kpezeshki/16CH_PSU/multichannelheaterdriver_amc7836/amc7836/AMC7836IPAPR.step

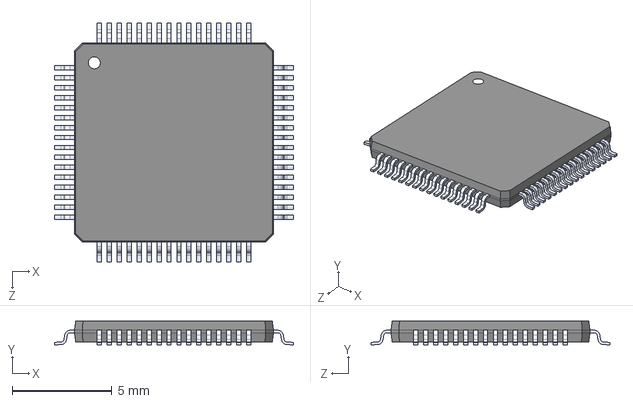
[picture p1: CAD file, 2025-02-01]
multichannelheaterdriver_amc7836/amc7836/AMC7836IPAPR.step
12.0 x 1.20 x 12.0 mm
