kpezeshki/16CH_PSU/multichannelheaterdriver_frontend/opamp_footprints/INA2180A4IDGKT.step

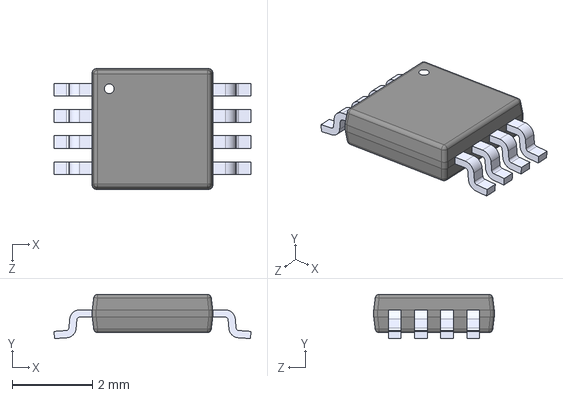
[picture p2: CAD file, 2025-02-01]
multichannelheaterdriver_frontend/opamp_footprints/INA2180A4IDGKT.step
4.90 x 1.10 x 3.00 mm
