kpezeshki/16CH_PSU/multichannelheaterdriver_frontend/opamp_footprints/ALM2403QPWPRQ1.step

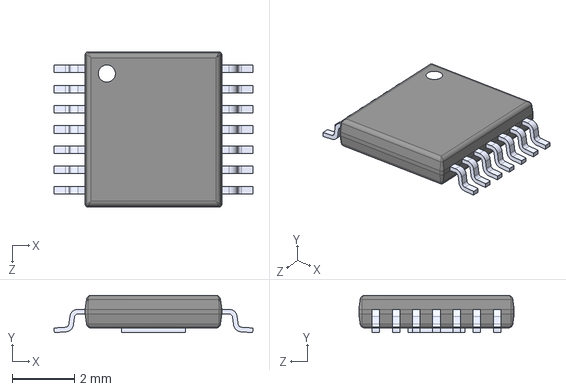
[picture p3: CAD file, 2025-02-01]
multichannelheaterdriver_frontend/opamp_footprints/ALM2403QPWPRQ1.step
6.40 x 1.20 x 5.00 mm
