kpezeshki/16CH_PSU/(threads)

Thread 1 (2025-02-01):

No firmware or software support for auxiliary ADCs on the AMC7836

kpezeshki, 2025-02-01:
Some of the AMC7836 single-ended ADCs are used internally for voltage rail monitoring, and some are broken out to headers on the data converter PCB. There is currently no firmware or GUI support for these. This should be added.

Thread 2 (2025-02-01):

High current tracks should all be >0.25 mm

kpezeshki, 2025-02-01:
The segment of track from the power op amp to shunt resistor is 0.25 mm. This should be increased to 0.5 mm to fix electromigration issues when the channel is operated at high current.
