kpezeshki/16CH_PSU/multichannelheaterdriver_amc7836/schematic.pdf

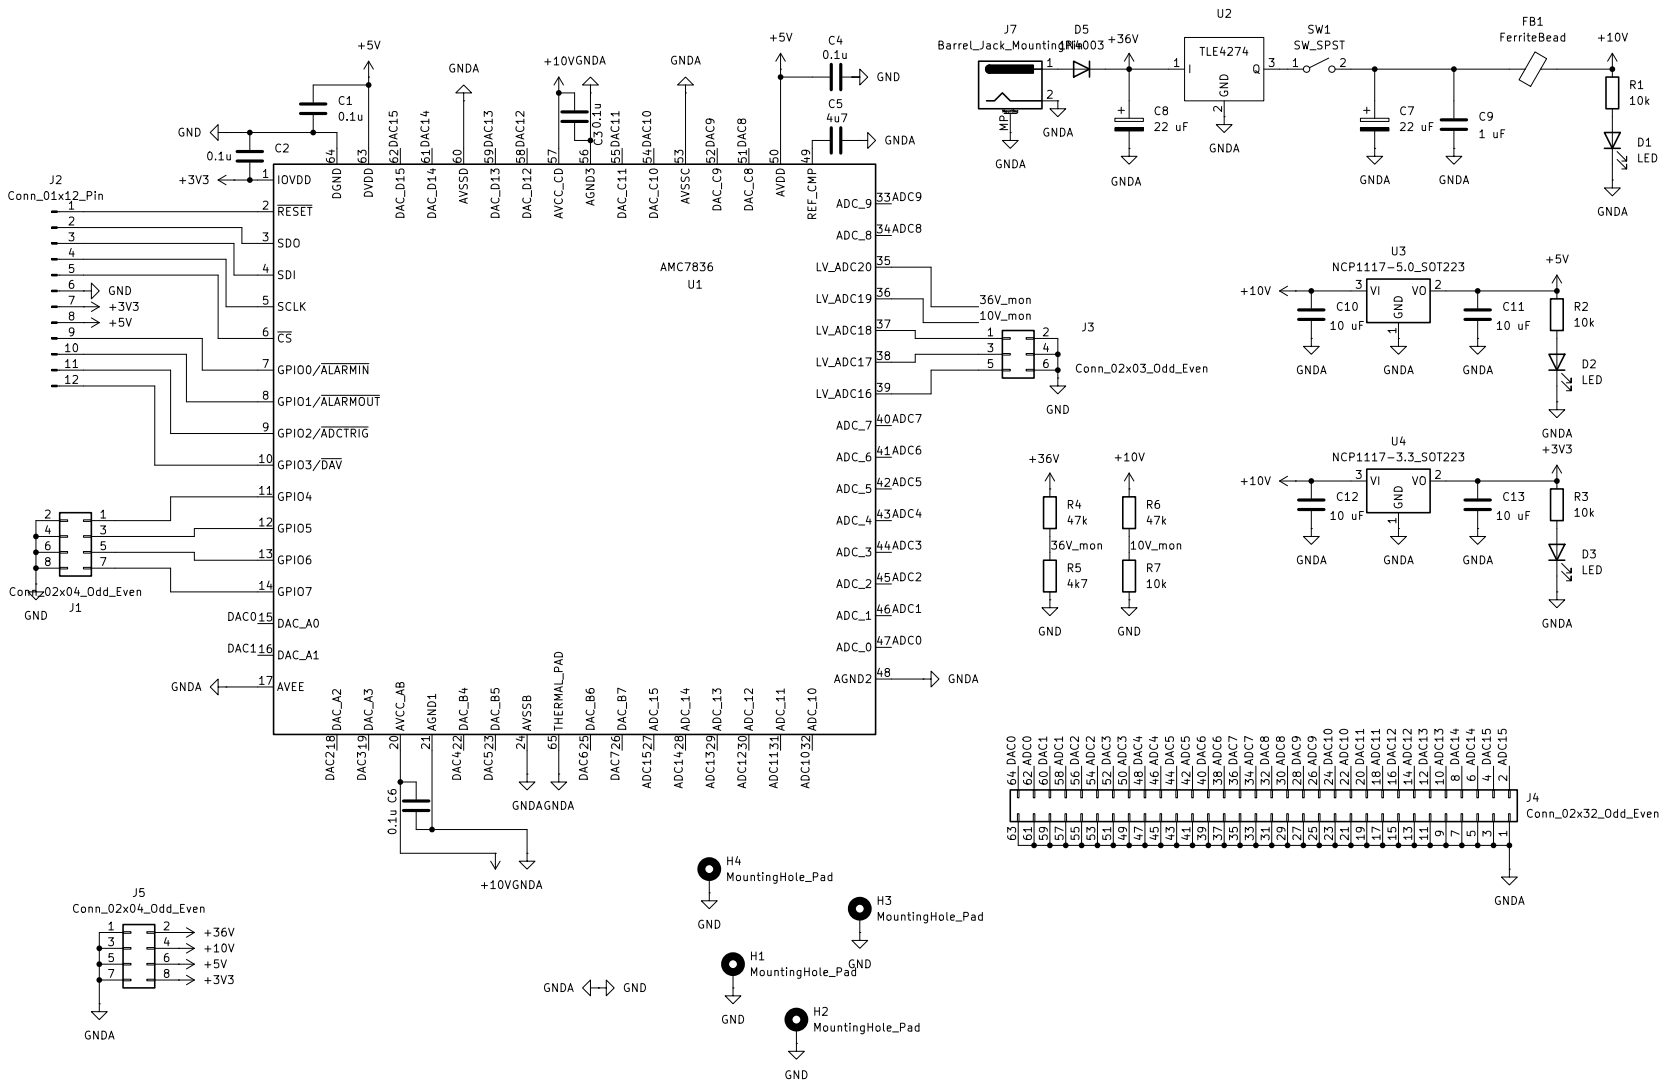
[picture p4: page 1]
