kpezeshki/16CH_PSU/multichannelheaterdriver_amc7836/layout.pdf

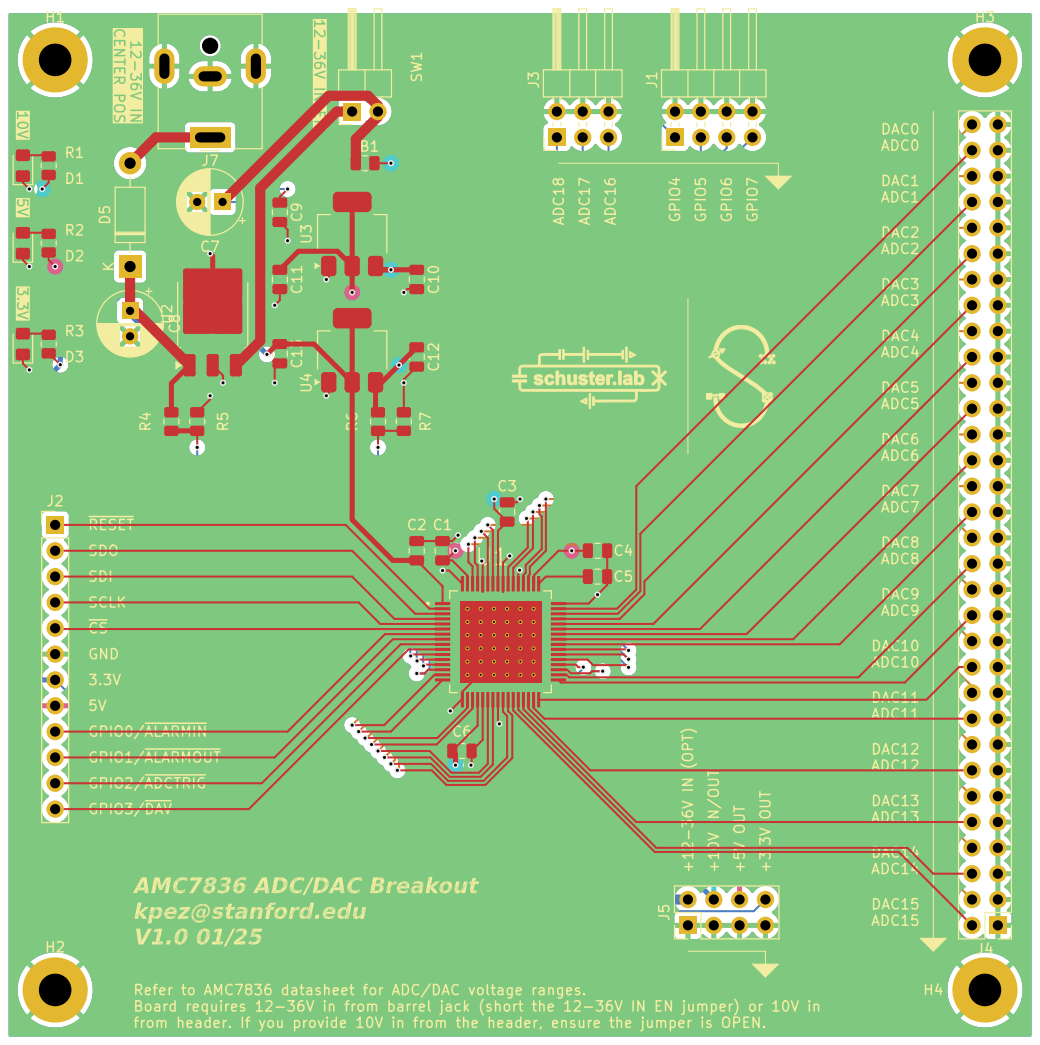
[picture p5: page 1]
