kpezeshki/16CH_PSU/multichannelheaterdriver_mcu/multichannelheaterdriver_mcu.kicad_pcb

## KiCad design multichannelheaterdriver_mcu/multichannelheaterdriver_mcu.kicad_pcb (2025-02-01)

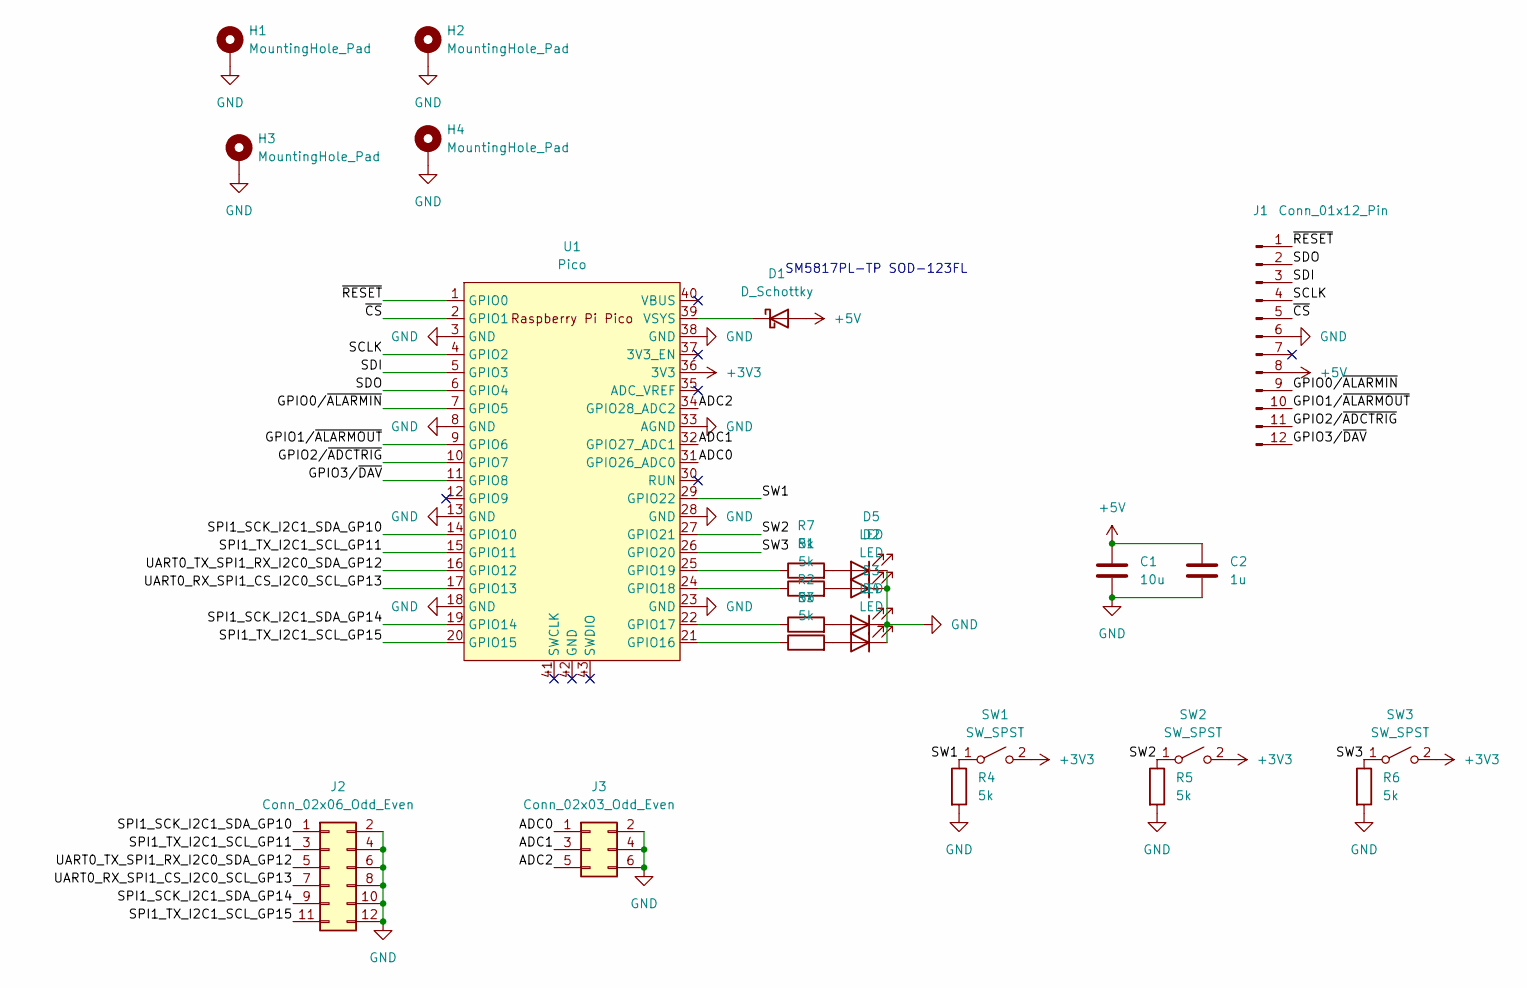
[picture p6: schematic multichannelheaterdriver_mcu.kicad_sch]

Parts:
C1: 10u; C_0805_2012Metric
C2: 1u; C_0805_2012Metric
D1: D_Schottky; D_SOD-123F
D2, D3, D4, D5: LED; LED_0805_2012Metric
H1, H2, H3, H4: MountingHole_Pad; MountingHole_3.2mm_M3_Pad
J1: Conn_01x12_Pin; PinHeader_1x12_P2.54mm_Vertical
J2: Conn_02x06_Odd_Even; PinHeader_2x06_P2.54mm_Horizontal
J3: Conn_02x03_Odd_Even; PinHeader_2x03_P2.54mm_Horizontal
R1, R2, R3, R4, R5, R6, R7: 5k; R_0805_2012Metric
SW1, SW2, SW3: SW_SPST; SW_Tactile_SPST_Angled_PTS645Vx31-2LFS
U1: Pico; RPi_Pico_SMD_TH

Connections:
+3V3: SW1.2 (B), SW2.2 (B), SW3.2 (B), U1.36 (3V3)
+5V: C1.1, C2.1, D1.2 (A), J1.8
/ADC0: J3.1, U1.31 (GPIO26_ADC0)
/ADC1: J3.3, U1.32 (GPIO27_ADC1)
/ADC2: J3.5, U1.34 (GPIO28_ADC2)
/GPIO0/~ALARMIN: J1.9, U1.7 (GPIO5)
/GPIO1/~ALARMOUT: J1.10, U1.9 (GPIO6)
/GPIO2/~ADCTRIG: J1.11, U1.10 (GPIO7)
/GPIO3/~DAV: J1.12, U1.11 (GPIO8)
/SCLK: J1.4, U1.4 (GPIO2)
/SDI: J1.3, U1.5 (GPIO3)
/SDO: J1.2, U1.6 (GPIO4)
/SPI1_SCK_I2C1_SDA_GP10: J2.1, U1.14 (GPIO10)
/SPI1_SCK_I2C1_SDA_GP14: J2.9, U1.19 (GPIO14)
/SPI1_TX_I2C1_SCL_GP11: J2.3, U1.15 (GPIO11)
/SPI1_TX_I2C1_SCL_GP15: J2.11, U1.20 (GPIO15)
/SW1: R4.1, SW1.1 (A), U1.29 (GPIO22)
/SW2: R5.1, SW2.1 (A), U1.27 (GPIO21)
/SW3: R6.1, SW3.1 (A), U1.26 (GPIO20)
/UART0_RX_SPI1_CS_I2C0_SCL_GP13: J2.7, U1.17 (GPIO13)
/UART0_TX_SPI1_RX_I2C0_SDA_GP12: J2.5, U1.16 (GPIO12)
/~CS: J1.5, U1.2 (GPIO1)
/~RESET: J1.1, U1.1 (GPIO0)
GND: C1.2, C2.2, D2.1 (K), D3.1 (K), D4.1 (K), D5.1 (K), H1.1, H2.1, H3.1, H4.1, J1.6, J2.2, J2.4, J2.6, J2.8, J2.10, J2.12, J3.2, J3.4, J3.6, R4.2, R5.2, R6.2, U1.3 (GND), U1.8 (GND), U1.13 (GND), U1.18 (GND), U1.23 (GND), U1.28 (GND), U1.33 (AGND), U1.38 (GND)
unnamed: D1.1 (K), U1.39 (VSYS)
unnamed: D2.2 (A), R1.2
unnamed: D3.2 (A), R2.2
unnamed: D4.2 (A), R3.2
unnamed: D5.2 (A), R7.2
unnamed: R3.1, U1.21 (GPIO16)
unnamed: R2.1, U1.22 (GPIO17)
unnamed: R1.1, U1.24 (GPIO18)
unnamed: R7.1, U1.25 (GPIO19)

Notes on the sheet:
SM5817PL-TP SOD-123FL

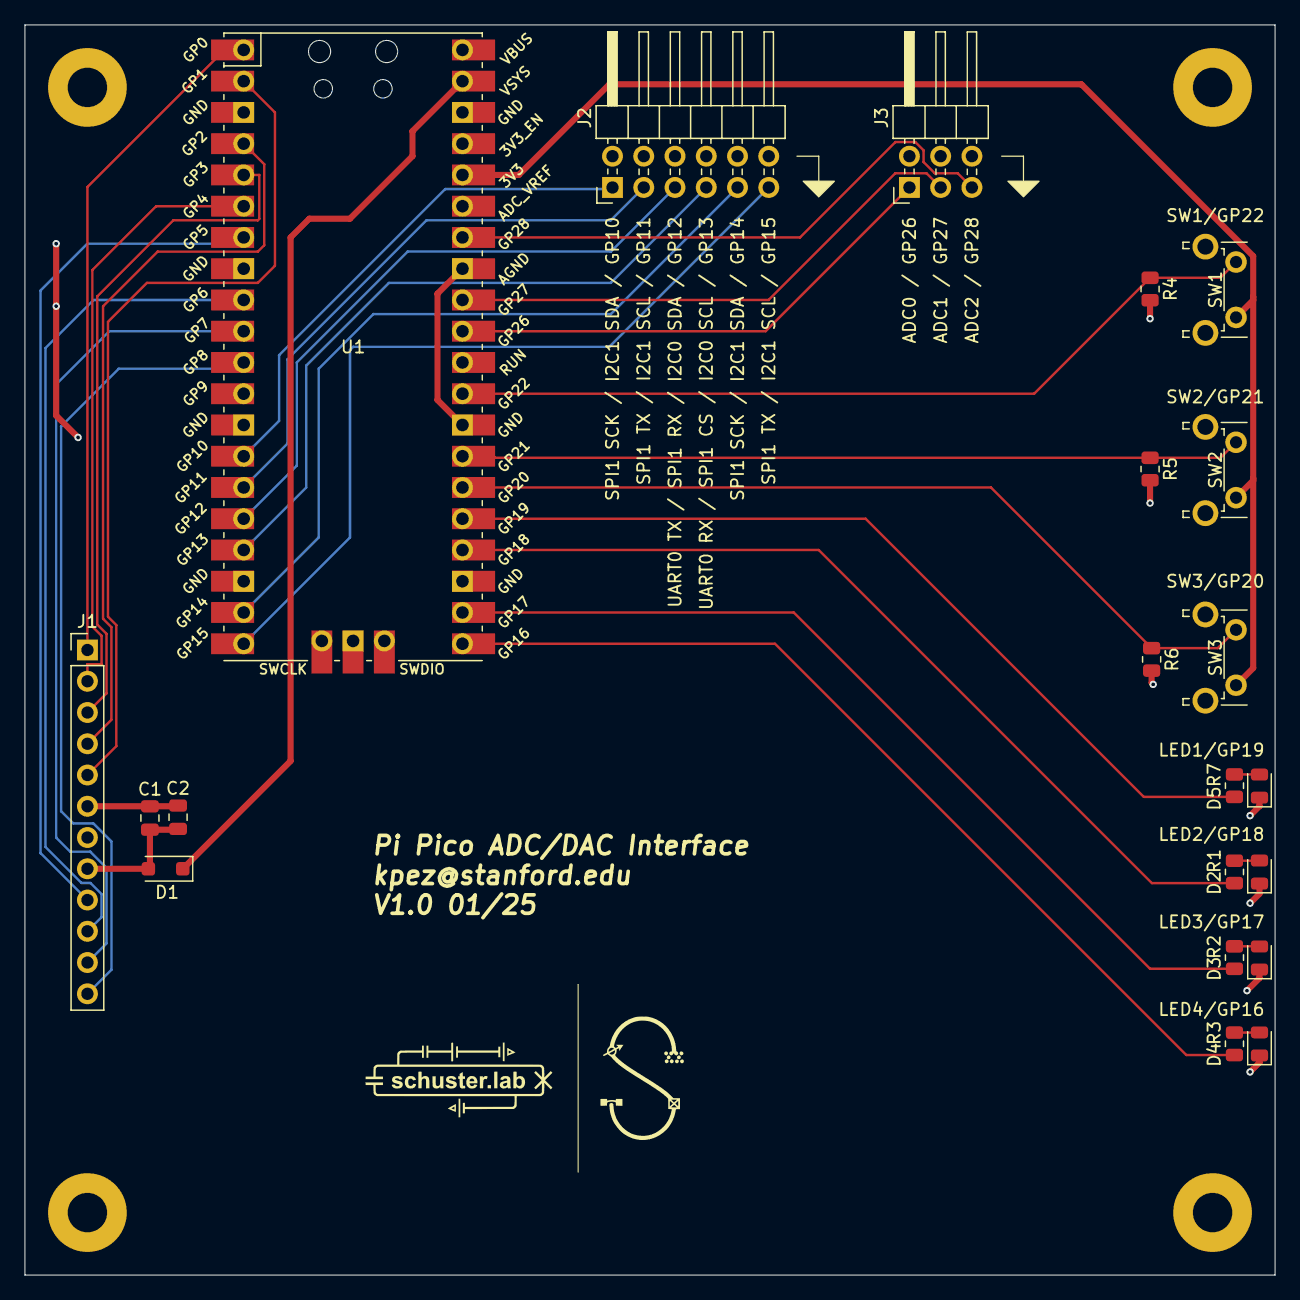
[picture p7: board multichannelheaterdriver_mcu.kicad_pcb from above]

Board: 2 copper layers, 101.6 x 101.6 mm, 25 parts (0 on the bottom side), 33 nets.
