kpezeshki/16CH_PSU/multichannelheaterdriver_amc7836/multichannelheaterdriver_amc7836.kicad_pcb

## KiCad design multichannelheaterdriver_amc7836/multichannelheaterdriver_amc7836.kicad_pcb (2025-02-01)

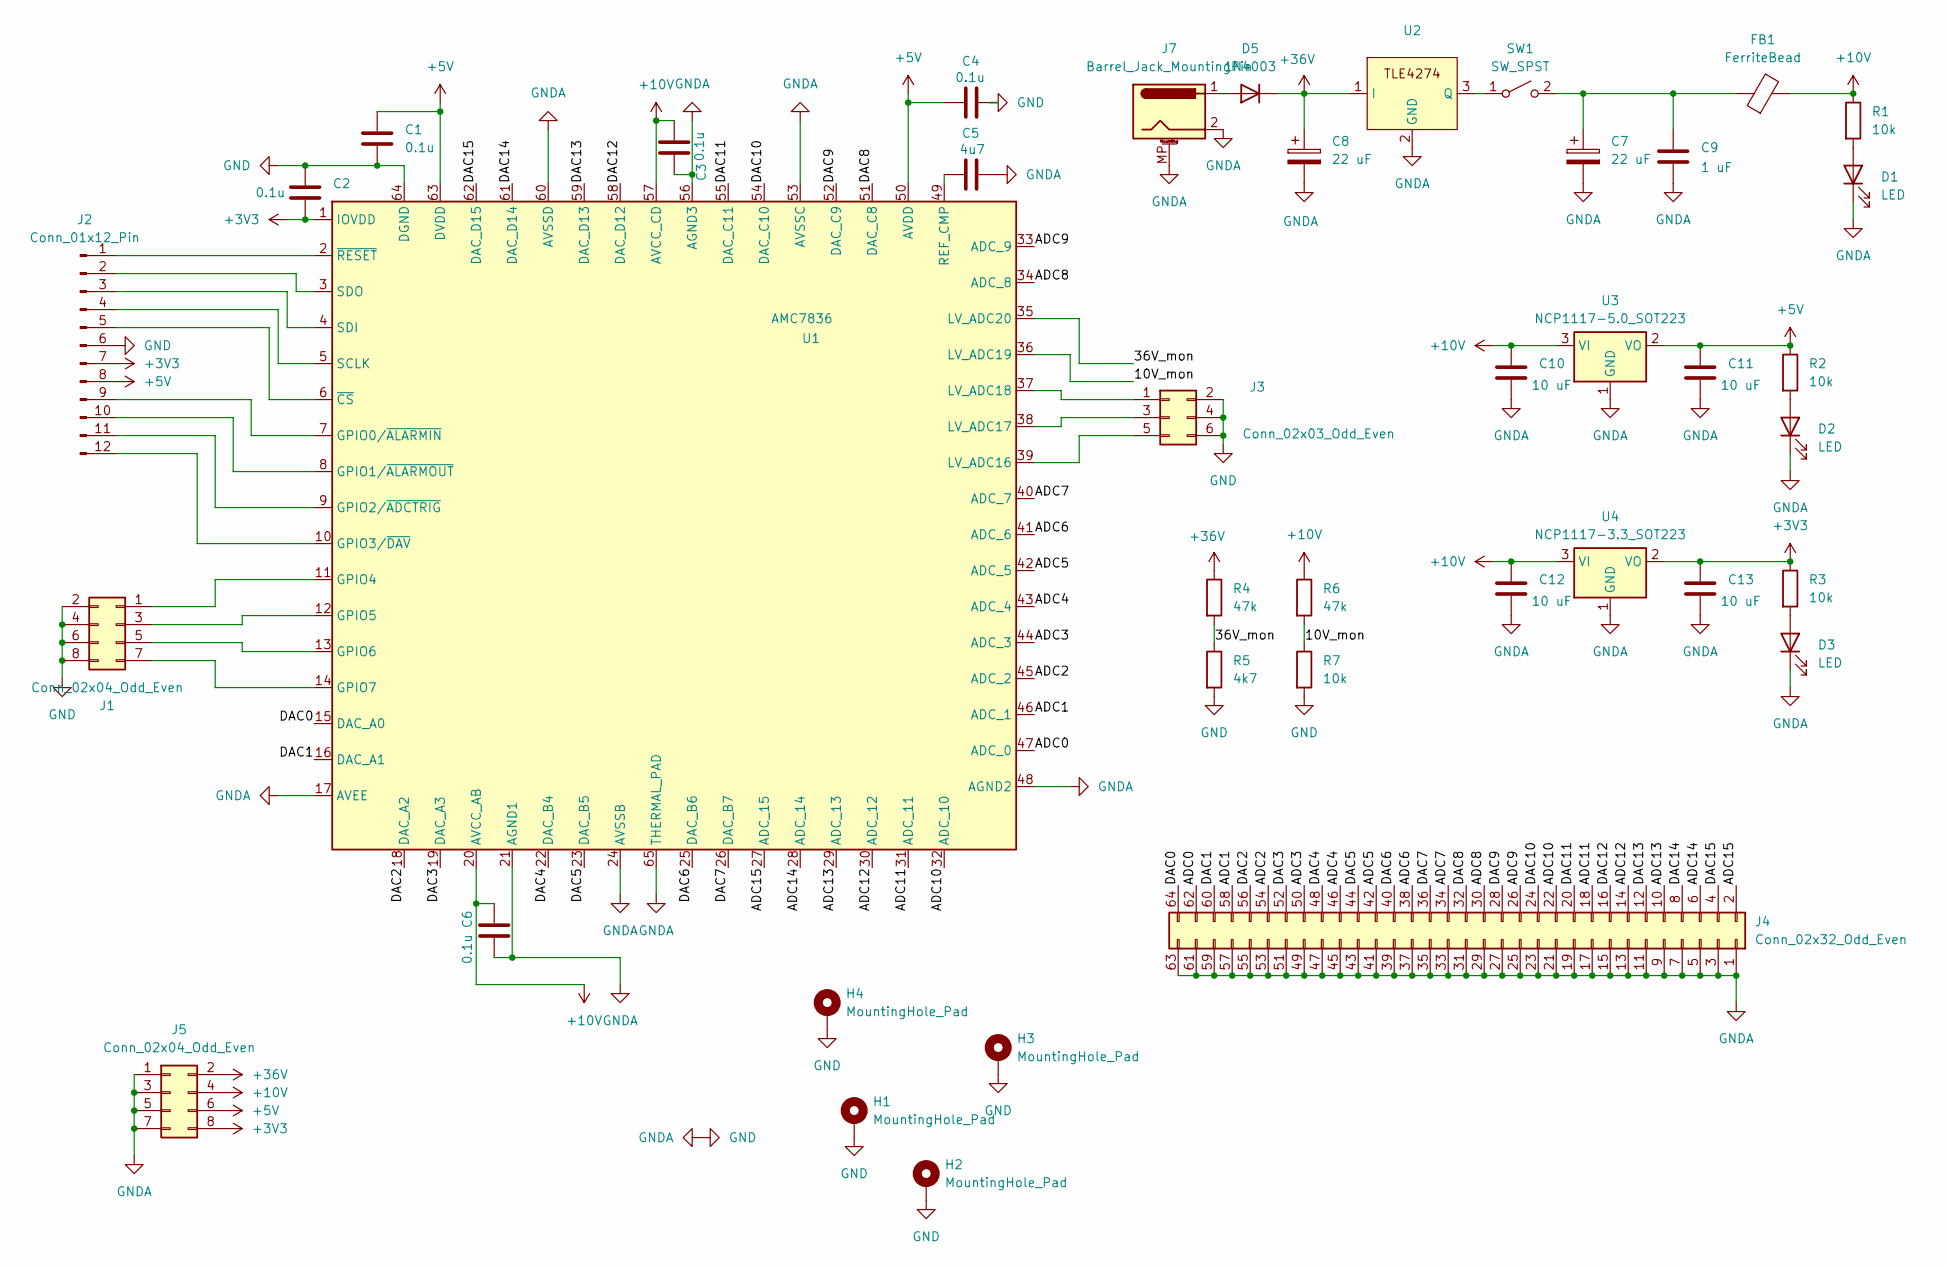
[picture p8: schematic multichannelheaterdriver_amc7836.kicad_sch]

Parts:
C1, C2, C3, C4, C6: 0.1u; C_0805_2012Metric
C5: 4u7; C_0805_2012Metric
C7, C8: 22 uF; CP_Radial_D6.3mm_P2.50mm
C9: 1 uF; C_0805_2012Metric
C10, C11, C12, C13: 10 uF; C_0805_2012Metric
D1, D2, D3: LED; LED_0805_2012Metric_Pad1.15x1.40mm_HandSolder
D5: 1N4003; D_DO-41_SOD81_P10.16mm_Horizontal
FB1: FerriteBead; R_0805_2012Metric
H1, H2, H3, H4: MountingHole_Pad; MountingHole_3.2mm_M3_Pad
J1: Conn_02x04_Odd_Even; PinHeader_2x04_P2.54mm_Horizontal
J2: Conn_01x12_Pin; PinHeader_1x12_P2.54mm_Vertical
J3: Conn_02x03_Odd_Even; PinHeader_2x03_P2.54mm_Horizontal
J4: Conn_02x32_Odd_Even; PinHeader_2x32_P2.54mm_Vertical
J5: Conn_02x04_Odd_Even; PinHeader_2x04_P2.54mm_Vertical
J7: Barrel_Jack_MountingPin; BarrelJack_CUI_PJ-063AH_Horizontal
R1, R2, R3, R7: 10k; R_0805_2012Metric
R4, R6: 47k; R_0805_2012Metric
R5: 4k7; R_0805_2012Metric
SW1: SW_SPST; PinHeader_1x02_P2.54mm_Horizontal
U1: AMC7836; IC_AMC7812BSPAP
U2: TO-252-3_TabPin2
U3: NCP1117-5.0_SOT223; SOT-223-3_TabPin2
U4: NCP1117-3.3_SOT223; SOT-223-3_TabPin2

Connections:
+3V3: C2.2, C13.1, J2.7, J5.8, R3.1, U1.1 (IOVDD), U4.2 (VO)
+5V: C1.1, C4.1, C11.1, J2.8, J5.6, R2.1, U1.50 (AVDD), U1.63 (DVDD), U3.2 (VO)
+10V: C3.1, C6.1, C10.1, C12.1, FB1.2, J5.4, R1.1, R6.1, U1.20 (AVCC_AB), U1.57 (AVCC_CD), U3.3 (VI), U4.3 (VI)
+36V: C8.1, D5.1 (K), J5.2, R4.1, U2.1 (I)
/10V_mon: R6.2, R7.1, U1.36 (LV_ADC19)
/36V_mon: R4.2, R5.1, U1.35 (LV_ADC20)
/ADC0: J4.62, U1.47 (ADC_0)
/ADC1: J4.58, U1.46 (ADC_1)
/ADC2: J4.54, U1.45 (ADC_2)
/ADC3: J4.50, U1.44 (ADC_3)
/ADC4: J4.46, U1.43 (ADC_4)
/ADC5: J4.42, U1.42 (ADC_5)
/ADC6: J4.38, U1.41 (ADC_6)
/ADC7: J4.34, U1.40 (ADC_7)
/ADC8: J4.30, U1.34 (ADC_8)
/ADC9: J4.26, U1.33 (ADC_9)
/ADC10: J4.22, U1.32 (ADC_10)
/ADC11: J4.18, U1.31 (ADC_11)
/ADC12: J4.14, U1.30 (ADC_12)
/ADC13: J4.10, U1.29 (ADC_13)
/ADC14: J4.6, U1.28 (ADC_14)
/ADC15: J4.2, U1.27 (ADC_15)
/DAC0: J4.64, U1.15 (DAC_A0)
/DAC1: J4.60, U1.16 (DAC_A1)
/DAC2: J4.56, U1.18 (DAC_A2)
/DAC3: J4.52, U1.19 (DAC_A3)
/DAC4: J4.48, U1.22 (DAC_B4)
/DAC5: J4.44, U1.23 (DAC_B5)
/DAC6: J4.40, U1.25 (DAC_B6)
/DAC7: J4.36, U1.26 (DAC_B7)
/DAC8: J4.32, U1.51 (DAC_C8)
/DAC9: J4.28, U1.52 (DAC_C9)
/DAC10: J4.24, U1.54 (DAC_C10)
/DAC11: J4.20, U1.55 (DAC_C11)
/DAC12: J4.16, U1.58 (DAC_D12)
/DAC13: J4.12, U1.59 (DAC_D13)
/DAC14: J4.8, U1.61 (DAC_D14)
/DAC15: J4.4, U1.62 (DAC_D15)
GND: C1.2, C2.1, C3.2, C4.2, C5.2, C6.2, C7.2, C8.2, C9.2, C10.2, C11.2, C12.2, C13.2, D1.1 (K), D2.1 (K), D3.1 (K), H1.1, H2.1, H3.1, H4.1, J1.2, J1.4, J1.6, J1.8, J2.6, J3.2, J3.4, J3.6, J4.1, J4.3, J4.5, J4.7, J4.9, J4.11, J4.13, J4.15, J4.17, J4.19, J4.21, J4.23, J4.25, J4.27, J4.29, J4.31, J4.33, J4.35, J4.37, J4.39, J4.41, J4.43, J4.45, J4.47, J4.49, J4.51, J4.53, J4.55, J4.57, J4.59, J4.61, J4.63, J5.1, J5.3, J5.5, J5.7, J7.2, J7.MP (MountPin), R5.2, R7.2, U1.17 (AVEE), U1.21 (AGND1), U1.24 (AVSSB), U1.48 (AGND2), U1.53 (AVSSC), U1.56 (AGND3), U1.60 (AVSSD), U1.64 (DGND), U1.65 (THERMAL_PAD), U2.2 (GND), U3.1 (GND), U4.1 (GND)
unnamed: D1.2 (A), R1.2
unnamed: D2.2 (A), R2.2
unnamed: D3.2 (A), R3.2
unnamed: D5.2 (A), J7.1
unnamed: J1.1, U1.11 (GPIO4)
unnamed: J1.3, U1.12 (GPIO5)
unnamed: J1.5, U1.13 (GPIO6)
unnamed: J1.7, U1.14 (GPIO7)
unnamed: J2.1, U1.2 (~RESET)
unnamed: J2.2, U1.3 (SDO)
unnamed: J2.3, U1.4 (SDI)
unnamed: J2.4, U1.5 (SCLK)
unnamed: J2.5, U1.6 (~CS)
unnamed: J2.9, U1.7 (GPIO0/~ALARMIN)
unnamed: J2.10, U1.8 (GPIO1/~ALARMOUT)
unnamed: J2.11, U1.9 (GPIO2/~ADCTRIG)
unnamed: J2.12, U1.10 (GPIO3/~DAV)
unnamed: J3.1, U1.37 (LV_ADC18)
unnamed: J3.3, U1.38 (LV_ADC17)
unnamed: J3.5, U1.39 (LV_ADC16)
unnamed: SW1.1 (A), U2.3 (Q)
unnamed: C7.1, C9.1, FB1.1, SW1.2 (B)
unnamed: C5.1, U1.49 (REF_CMP)

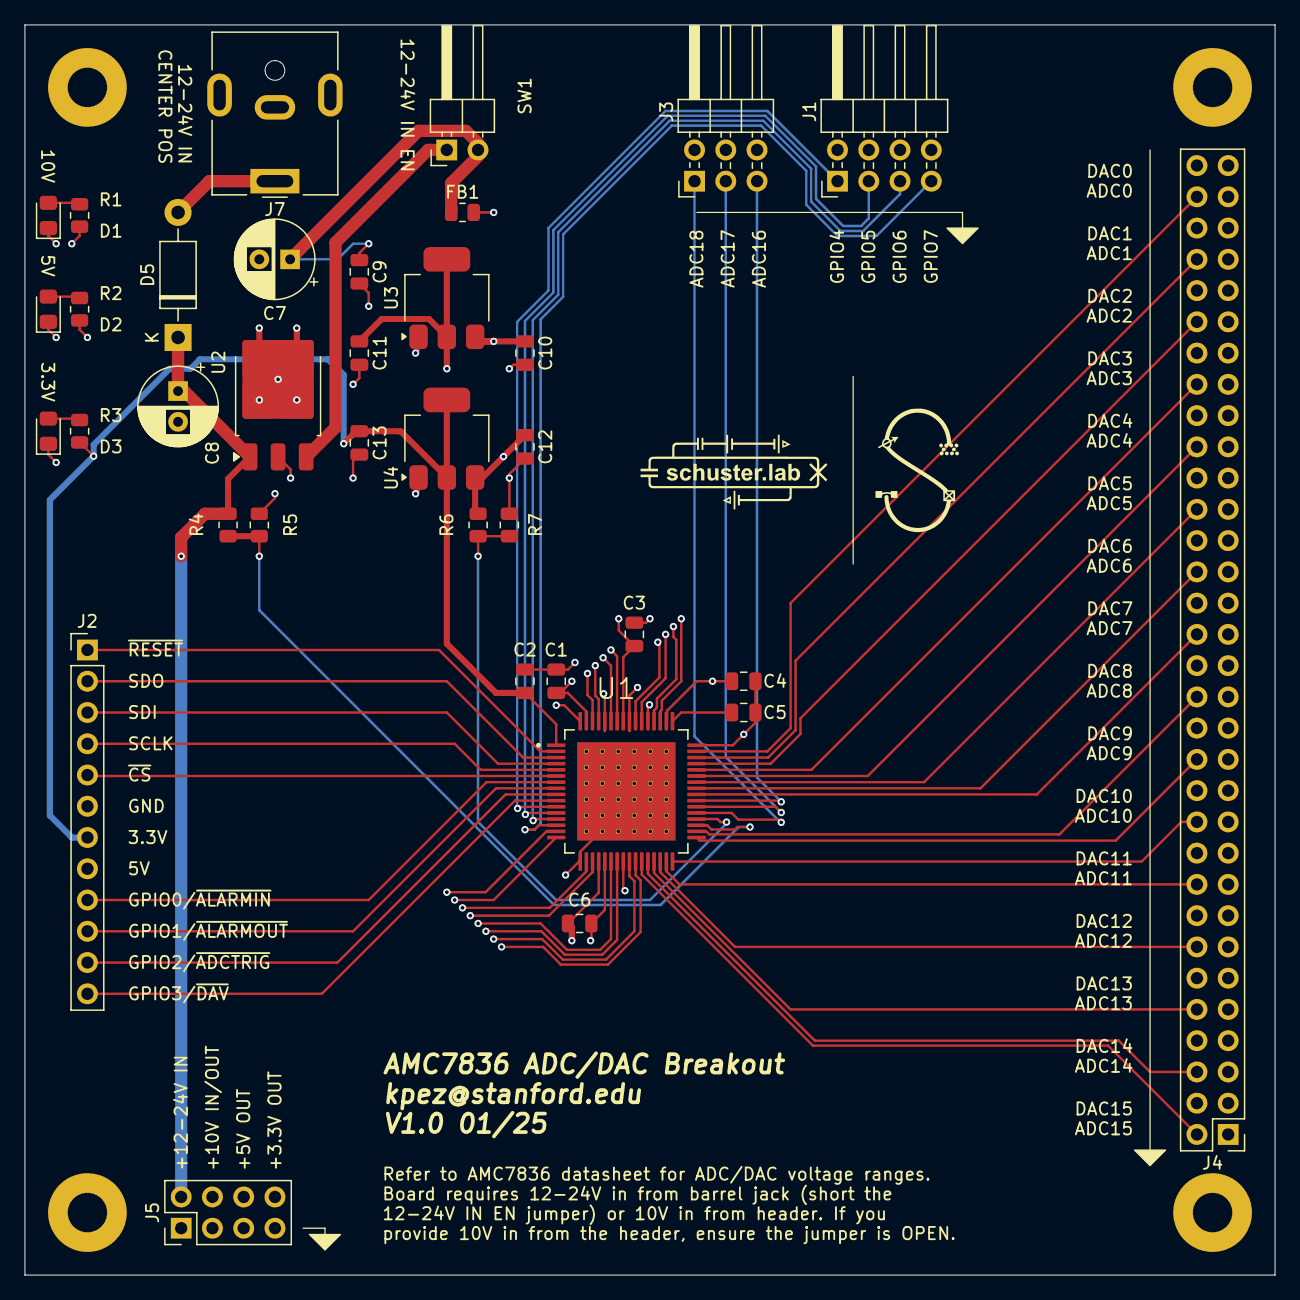
[picture p9: board multichannelheaterdriver_amc7836.kicad_pcb from above]

Board: 6 copper layers, 101.6 x 101.6 mm, 40 parts (0 on the bottom side), 62 nets.
