kpezeshki/16CH_PSU/multichannelheaterdriver_frontend/multichannelheaterdriver_frontend.kicad_pcb

## KiCad design multichannelheaterdriver_frontend/multichannelheaterdriver_frontend.kicad_pcb (2025-02-01)

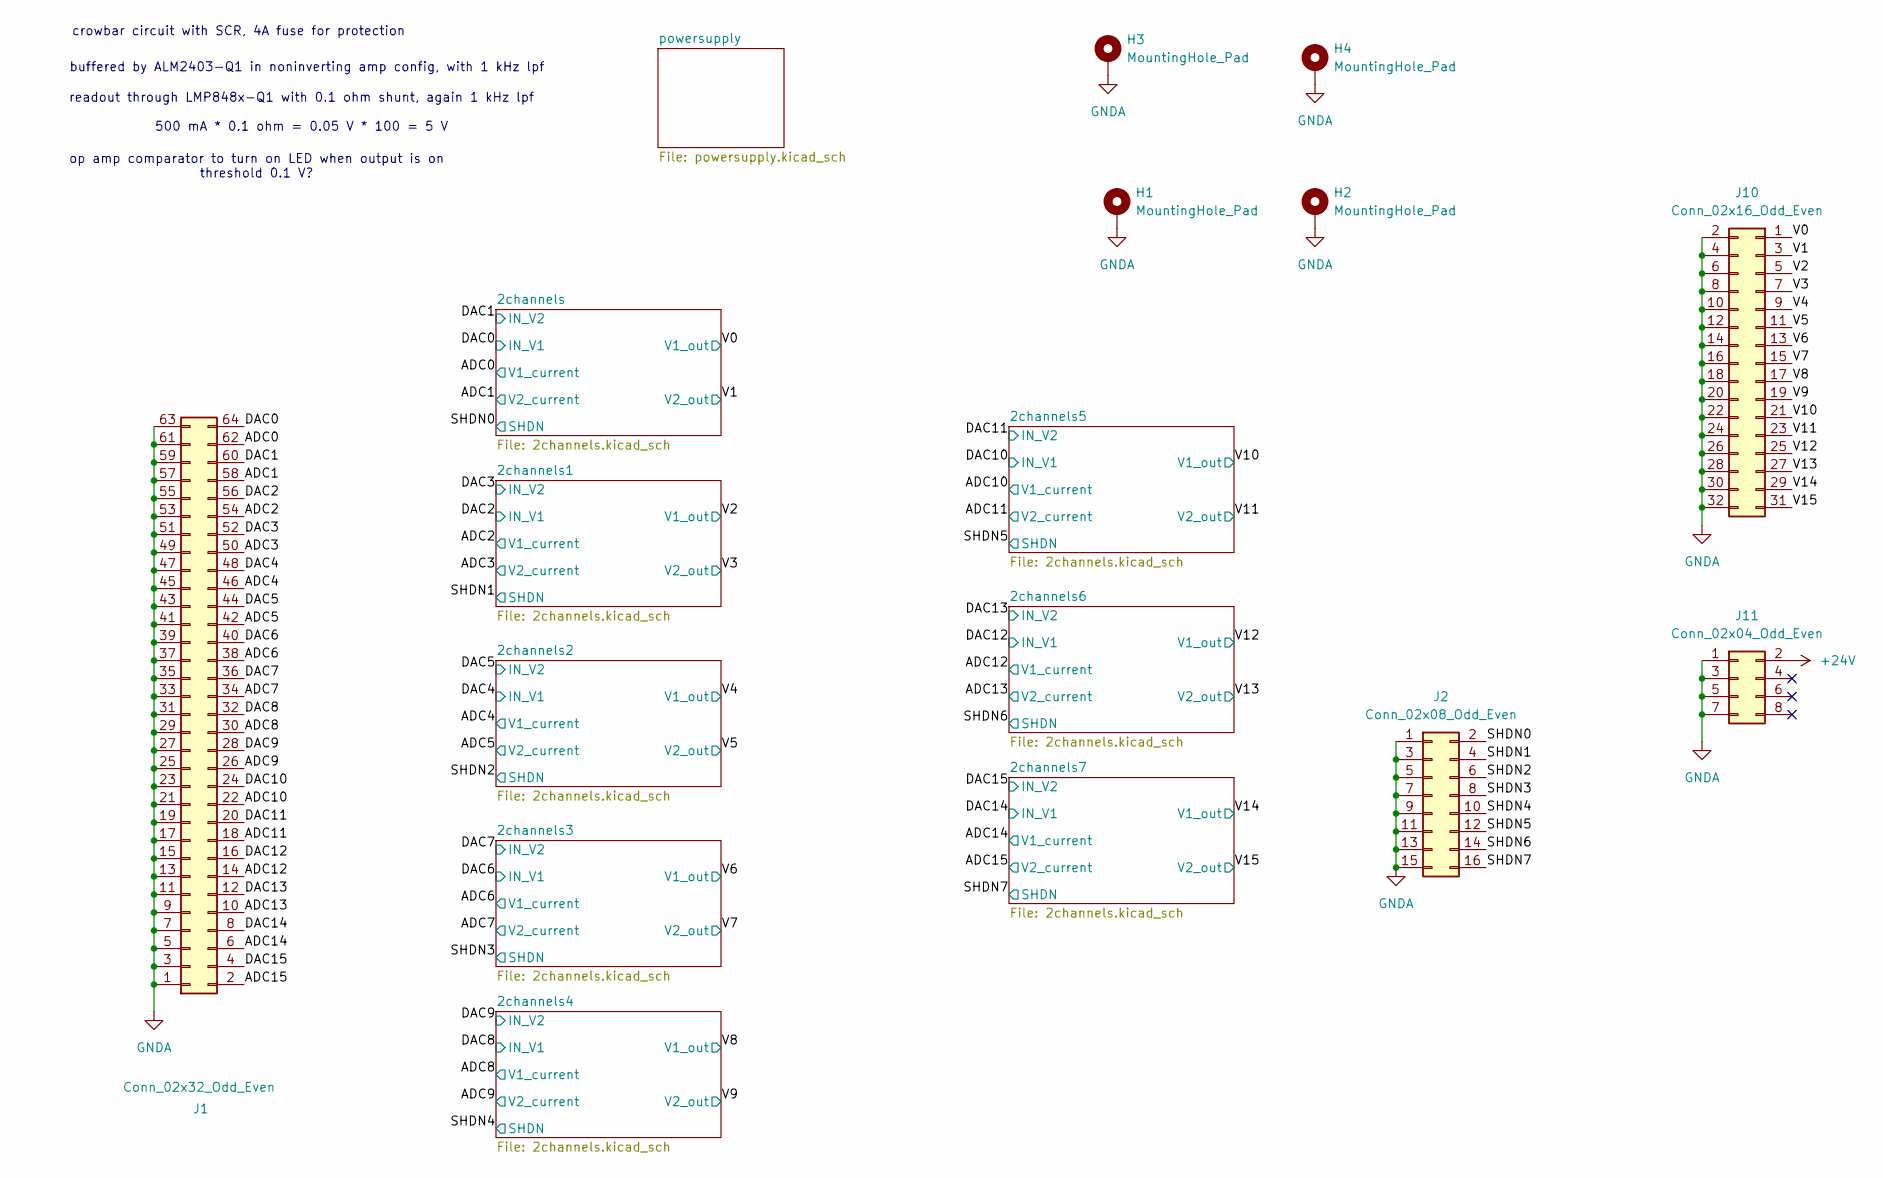
[picture p10: schematic multichannelheaterdriver_frontend.kicad_sch]

Parts:
H1, H2, H3, H4: MountingHole_Pad; MountingHole_3.2mm_M3_Pad
J1: Conn_02x32_Odd_Even; PinHeader_2x32_P2.54mm_Vertical
J2: Conn_02x08_Odd_Even; PinHeader_2x08_P2.54mm_Vertical
J10: Conn_02x16_Odd_Even; PinHeader_2x16_P2.54mm_Horizontal
J11: Conn_02x04_Odd_Even; PinHeader_2x04_P2.54mm_Vertical

Connections:
+24V: J11.2; also elsewhere on the board
/ADC0: J1.62; also elsewhere on the board
/ADC1: J1.58; also elsewhere on the board
/ADC2: J1.54; also elsewhere on the board
/ADC3: J1.50; also elsewhere on the board
/ADC4: J1.46; also elsewhere on the board
/ADC5: J1.42; also elsewhere on the board
/ADC6: J1.38; also elsewhere on the board
/ADC7: J1.34; also elsewhere on the board
/ADC8: J1.30; also elsewhere on the board
/ADC9: J1.26; also elsewhere on the board
/ADC10: J1.22; also elsewhere on the board
/ADC11: J1.18; also elsewhere on the board
/ADC12: J1.14; also elsewhere on the board
/ADC13: J1.10; also elsewhere on the board
/ADC14: J1.6; also elsewhere on the board
/ADC15: J1.2; also elsewhere on the board
/DAC0: J1.64; also elsewhere on the board
/DAC1: J1.60; also elsewhere on the board
/DAC2: J1.56; also elsewhere on the board
/DAC3: J1.52; also elsewhere on the board
/DAC4: J1.48; also elsewhere on the board
/DAC5: J1.44; also elsewhere on the board
/DAC6: J1.40; also elsewhere on the board
/DAC7: J1.36; also elsewhere on the board
/DAC8: J1.32; also elsewhere on the board
/DAC9: J1.28; also elsewhere on the board
/DAC10: J1.24; also elsewhere on the board
/DAC11: J1.20; also elsewhere on the board
/DAC12: J1.16; also elsewhere on the board
/DAC13: J1.12; also elsewhere on the board
/DAC14: J1.8; also elsewhere on the board
/DAC15: J1.4; also elsewhere on the board
/SHDN0: J2.2; also elsewhere on the board
/SHDN1: J2.4; also elsewhere on the board
/SHDN2: J2.6; also elsewhere on the board
/SHDN3: J2.8; also elsewhere on the board
/SHDN4: J2.10; also elsewhere on the board
/SHDN5: J2.12; also elsewhere on the board
/SHDN6: J2.14; also elsewhere on the board
/SHDN7: J2.16; also elsewhere on the board
/V0: J10.1; also elsewhere on the board
/V1: J10.3; also elsewhere on the board
/V2: J10.5; also elsewhere on the board
/V3: J10.7; also elsewhere on the board
/V4: J10.9; also elsewhere on the board
/V5: J10.11; also elsewhere on the board
/V6: J10.13; also elsewhere on the board
/V7: J10.15; also elsewhere on the board
/V8: J10.17; also elsewhere on the board
/V9: J10.19; also elsewhere on the board
/V10: J10.21; also elsewhere on the board
/V11: J10.23; also elsewhere on the board
/V12: J10.25; also elsewhere on the board
/V13: J10.27; also elsewhere on the board
/V14: J10.29; also elsewhere on the board
/V15: J10.31; also elsewhere on the board
GNDA: H1.1, H2.1, H3.1, H4.1, J1.1, J1.3, J1.5, J1.7, J1.9, J1.11, J1.13, J1.15, J1.17, J1.19, J1.21, J1.23, J1.25, J1.27, J1.29, J1.31, J1.33, J1.35, J1.37, J1.39, J1.41, J1.43, J1.45, J1.47, J1.49, J1.51, J1.53, J1.55, J1.57, J1.59, J1.61, J1.63, J2.1, J2.3, J2.5, J2.7, J2.9, J2.11, J2.13, J2.15, J10.2, J10.4, J10.6, J10.8, J10.10, J10.12, J10.14, J10.16, J10.18, J10.20, J10.22, J10.24, J10.26, J10.28, J10.30, J10.32, J11.1, J11.3, J11.5, J11.7; also elsewhere on the board

Notes on the sheet:
op amp comparator to turn on LED when output is on threshold 0.1 V?
buffered by ALM2403-Q1 in noninverting amp config, with 1 kHz lpf
crowbar circuit with SCR, 4A fuse for protection
readout through LMP848x-Q1 with 0.1 ohm shunt, again 1 kHz lpf 500 mA * 0.1 ohm = 0.05 V * 100 = 5 V

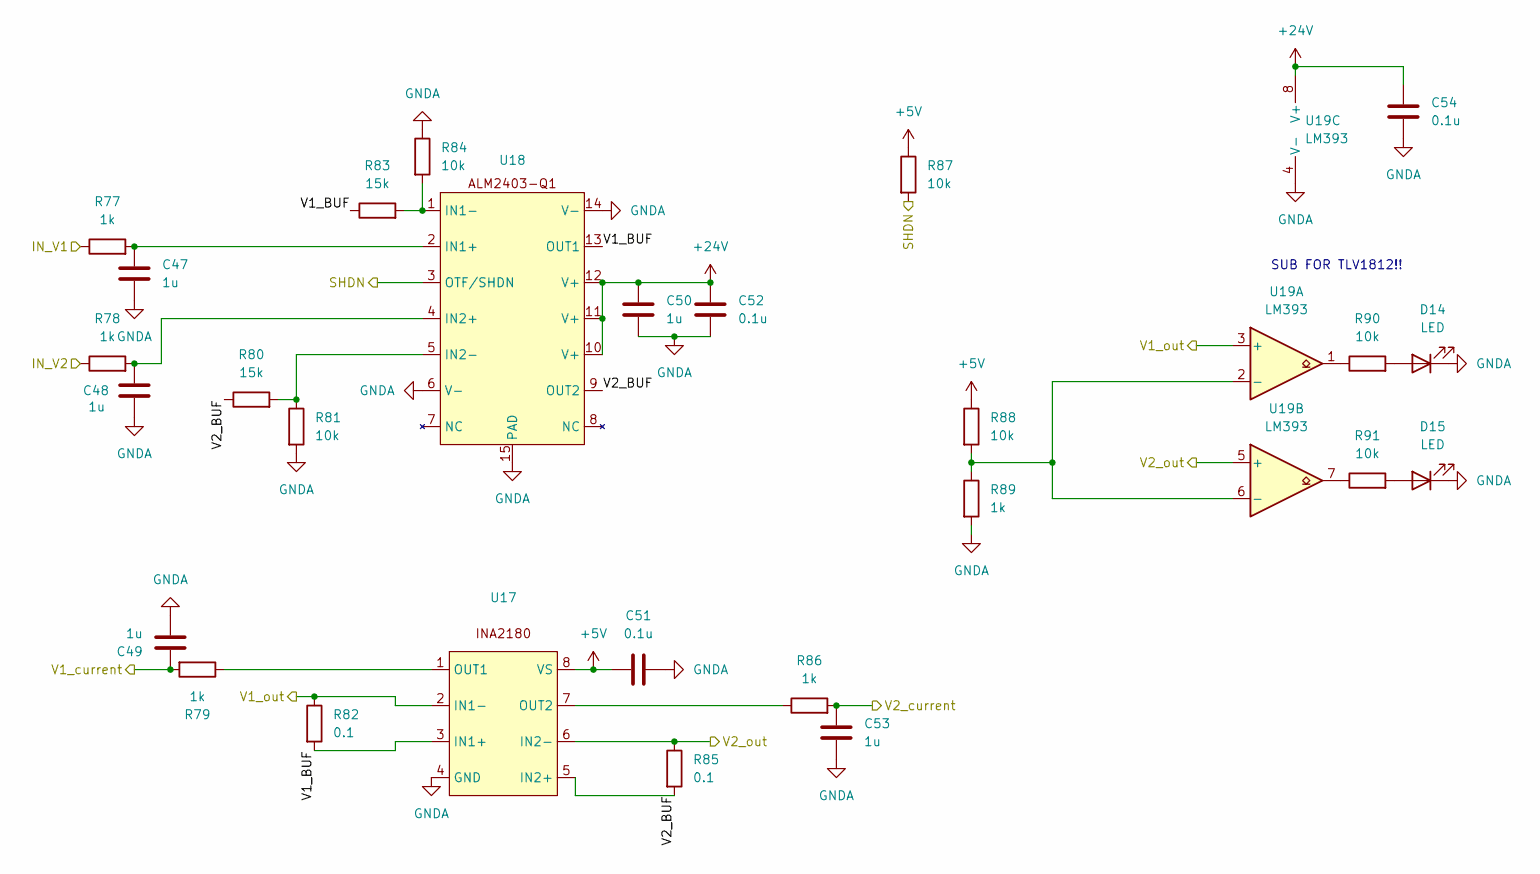
[picture p11: schematic 2channels.kicad_sch]

Parts:
C47, C48, C49, C50, C53: 1u; C_0603_1608Metric
C51, C52, C54: 0.1u; C_0603_1608Metric
D14, D15: LED; LED_0805_2012Metric
R77, R78, R79, R86, R89: 1k; R_0603_1608Metric
R80, R83: 15k; R_0603_1608Metric
R81, R84, R87, R88, R90, R91: 10k; R_0603_1608Metric
R82, R85: 0.1; R_0603_1608Metric
U17: VSSOP-8_3x3mm_P0.65mm
U18: IC_TPS27S100BPWPR
U19: LM393; SOIC-8_3.9x4.9mm_P1.27mm

Connections:
+5V: C51.1, R87.1, R88.1, U17.8 (VS); also elsewhere on the board
+24V: C50.1, C52.1, C54.1, U18.10 (V+), U18.11 (V+), U18.12 (V+), U19.8 (V+); also elsewhere on the board
/2channels5/V1_BUF: R82.2, R83.1, U17.3 (IN1+), U18.13 (OUT1)
/2channels5/V2_BUF: R80.1, R85.2, U17.5 (IN2+), U18.9 (OUT2)
/ADC10: C49.1, R79.2; also elsewhere on the board
/ADC11: C53.1, R86.2; also elsewhere on the board
/DAC10: R77.1; also elsewhere on the board
/DAC11: R78.1; also elsewhere on the board
/SHDN5: R87.2, U18.3 (OTF/SHDN); also elsewhere on the board
/V10: R82.1, U17.2 (IN1-), U19.3 (+); also elsewhere on the board
/V11: R85.1, U17.6 (IN2-), U19.5 (+); also elsewhere on the board
GNDA: C47.2, C48.2, C49.2, C50.2, C51.2, C52.2, C53.2, C54.2, D14.1 (K), D15.1 (K), R81.2, R84.1, R89.2, U17.4 (GND), U18.6 (V-), U18.14 (V-), U18.15 (PAD), U19.4 (V-); also elsewhere on the board
unnamed: D14.2 (A), R90.2
unnamed: D15.2 (A), R91.2
unnamed: R90.1, U19.1
unnamed: R91.1, U19.7
unnamed: R79.1, U17.1 (OUT1)
unnamed: R86.1, U17.7 (OUT2)
unnamed: C47.1, R77.2, U18.2 (IN1+)
unnamed: R83.2, R84.2, U18.1 (IN1-)
unnamed: C48.1, R78.2, U18.4 (IN2+)
unnamed: R80.2, R81.1, U18.5 (IN2-)
unnamed: R88.2, R89.1, U19.2 (-), U19.6 (-)

Parts of its further copies:
C7, C8, C9, C10, C13, C15, C16, C17, C18, C21, C23, C24, C25, C26, C29, C31, C32, C33, C34, C37, C39, C40, C41, C42, C45, C55, C56, C57, C58, C61, C63, C64, C65, C66, C69: 1u; C_0603_1608Metric
C11, C12, C14, C19, C20, C22, C27, C28, C30, C35, C36, C38, C43, C44, C46, C59, C60, C62, C67, C68, C70: 0.1u; C_0603_1608Metric
D4, D5, D6, D7, D8, D9, D10, D11, D12, D13, D16, D17, D18, D19: LED; LED_0805_2012Metric
R2, R3, R4, R11, R14, R17, R18, R19, R26, R29, R32, R33, R34, R41, R44, R47, R48, R49, R56, R59, R62, R63, R64, R71, R74, R92, R93, R94, R101, R104, R107, R108, R109, R116, R119: 1k; R_0603_1608Metric
R5, R8, R20, R23, R35, R38, R50, R53, R65, R68, R95, R98, R110, R113: 15k; R_0603_1608Metric
R6, R9, R12, R13, R15, R16, R21, R24, R27, R28, R30, R31, R36, R39, R42, R43, R45, R46, R51, R54, R57, R58, R60, R61, R66, R69, R72, R73, R75, R76, R96, R99, R102, R103, R105, R106, R111, R114, R117, R118, R120, R121: 10k; R_0603_1608Metric
R7, R10, R22, R25, R37, R40, R52, R55, R67, R70, R97, R100, R112, R115: 0.1; R_0603_1608Metric
U2, U5, U8, U11, U14, U20, U23: VSSOP-8_3x3mm_P0.65mm
U3, U6, U9, U12, U15, U21, U24: IC_TPS27S100BPWPR
U4, U7, U10, U13, U16, U22, U25: LM393; SOIC-8_3.9x4.9mm_P1.27mm

Connections of its further copies:
+5V: C11.1, C19.1, C27.1, C35.1, C43.1, C59.1, C67.1, R12.1, R13.1, R27.1, R28.1, R42.1, R43.1, R57.1, R58.1, R72.1, R73.1, R102.1, R103.1, R117.1, R118.1, U2.8 (VS), U5.8 (VS), U8.8 (VS), U11.8 (VS), U14.8 (VS), U20.8 (VS), U23.8 (VS); also elsewhere on the board
+24V: C10.1, C12.1, C14.1, C18.1, C20.1, C22.1, C26.1, C28.1, C30.1, C34.1, C36.1, C38.1, C42.1, C44.1, C46.1, C58.1, C60.1, C62.1, C66.1, C68.1, C70.1, U3.10 (V+), U3.11 (V+), U3.12 (V+), U4.8 (V+), U6.10 (V+), U6.11 (V+), U6.12 (V+), U7.8 (V+), U9.10 (V+), U9.11 (V+), U9.12 (V+), U10.8 (V+), U12.10 (V+), U12.11 (V+), U12.12 (V+), U13.8 (V+), U15.10 (V+), U15.11 (V+), U15.12 (V+), U16.8 (V+), U21.10 (V+), U21.11 (V+), U21.12 (V+), U22.8 (V+), U24.10 (V+), U24.11 (V+), U24.12 (V+), U25.8 (V+); also elsewhere on the board
/2channels1/V1_BUF: R22.2, R23.1, U5.3 (IN1+), U6.13 (OUT1)
/2channels1/V2_BUF: R20.1, R25.2, U5.5 (IN2+), U6.9 (OUT2)
/2channels2/V1_BUF: R37.2, R38.1, U8.3 (IN1+), U9.13 (OUT1)
/2channels2/V2_BUF: R35.1, R40.2, U8.5 (IN2+), U9.9 (OUT2)
/2channels3/V1_BUF: R52.2, R53.1, U11.3 (IN1+), U12.13 (OUT1)
/2channels3/V2_BUF: R50.1, R55.2, U11.5 (IN2+), U12.9 (OUT2)
/2channels4/V1_BUF: R67.2, R68.1, U14.3 (IN1+), U15.13 (OUT1)
/2channels4/V2_BUF: R65.1, R70.2, U14.5 (IN2+), U15.9 (OUT2)
/2channels6/V1_BUF: R97.2, R98.1, U20.3 (IN1+), U21.13 (OUT1)
/2channels6/V2_BUF: R95.1, R100.2, U20.5 (IN2+), U21.9 (OUT2)
/2channels7/V1_BUF: R112.2, R113.1, U23.3 (IN1+), U24.13 (OUT1)
/2channels7/V2_BUF: R110.1, R115.2, U23.5 (IN2+), U24.9 (OUT2)
/2channels/V1_BUF: R7.2, R8.1, U2.3 (IN1+), U3.13 (OUT1)
/2channels/V2_BUF: R5.1, R10.2, U2.5 (IN2+), U3.9 (OUT2)
/ADC0: C9.1, R4.2; also elsewhere on the board
/ADC1: C13.1, R11.2; also elsewhere on the board
/ADC2: C17.1, R19.2; also elsewhere on the board
/ADC3: C21.1, R26.2; also elsewhere on the board
/ADC4: C25.1, R34.2; also elsewhere on the board
/ADC5: C29.1, R41.2; also elsewhere on the board
/ADC6: C33.1, R49.2; also elsewhere on the board
/ADC7: C37.1, R56.2; also elsewhere on the board
/ADC8: C41.1, R64.2; also elsewhere on the board
/ADC9: C45.1, R71.2; also elsewhere on the board
/ADC12: C57.1, R94.2; also elsewhere on the board
/ADC13: C61.1, R101.2; also elsewhere on the board
/ADC14: C65.1, R109.2; also elsewhere on the board
/ADC15: C69.1, R116.2; also elsewhere on the board
/DAC0: R2.1; also elsewhere on the board
/DAC1: R3.1; also elsewhere on the board
/DAC2: R17.1; also elsewhere on the board
/DAC3: R18.1; also elsewhere on the board
/DAC4: R32.1; also elsewhere on the board
/DAC5: R33.1; also elsewhere on the board
/DAC6: R47.1; also elsewhere on the board
/DAC7: R48.1; also elsewhere on the board
/DAC8: R62.1; also elsewhere on the board
/DAC9: R63.1; also elsewhere on the board
/DAC12: R92.1; also elsewhere on the board
/DAC13: R93.1; also elsewhere on the board
/DAC14: R107.1; also elsewhere on the board
/DAC15: R108.1; also elsewhere on the board
/SHDN0: R12.2, U3.3 (OTF/SHDN); also elsewhere on the board
/SHDN1: R27.2, U6.3 (OTF/SHDN); also elsewhere on the board
/SHDN2: R42.2, U9.3 (OTF/SHDN); also elsewhere on the board
/SHDN3: R57.2, U12.3 (OTF/SHDN); also elsewhere on the board
/SHDN4: R72.2, U15.3 (OTF/SHDN); also elsewhere on the board
/SHDN6: R102.2, U21.3 (OTF/SHDN); also elsewhere on the board
/SHDN7: R117.2, U24.3 (OTF/SHDN); also elsewhere on the board
/V0: R7.1, U2.2 (IN1-), U4.3 (+); also elsewhere on the board
/V1: R10.1, U2.6 (IN2-), U4.5 (+); also elsewhere on the board
/V2: R22.1, U5.2 (IN1-), U7.3 (+); also elsewhere on the board
/V3: R25.1, U5.6 (IN2-), U7.5 (+); also elsewhere on the board
/V4: R37.1, U8.2 (IN1-), U10.3 (+); also elsewhere on the board
/V5: R40.1, U8.6 (IN2-), U10.5 (+); also elsewhere on the board
/V6: R52.1, U11.2 (IN1-), U13.3 (+); also elsewhere on the board
/V7: R55.1, U11.6 (IN2-), U13.5 (+); also elsewhere on the board
/V8: R67.1, U14.2 (IN1-), U16.3 (+); also elsewhere on the board
/V9: R70.1, U14.6 (IN2-), U16.5 (+); also elsewhere on the board
/V12: R97.1, U20.2 (IN1-), U22.3 (+); also elsewhere on the board
/V13: R100.1, U20.6 (IN2-), U22.5 (+); also elsewhere on the board
/V14: R112.1, U23.2 (IN1-), U25.3 (+); also elsewhere on the board
/V15: R115.1, U23.6 (IN2-), U25.5 (+); also elsewhere on the board
GNDA: C7.2, C8.2, C9.2, C10.2, C11.2, C12.2, C13.2, C14.2, C15.2, C16.2, C17.2, C18.2, C19.2, C20.2, C21.2, C22.2, C23.2, C24.2, C25.2, C26.2, C27.2, C28.2, C29.2, C30.2, C31.2, C32.2, C33.2, C34.2, C35.2, C36.2, C37.2, C38.2, C39.2, C40.2, C41.2, C42.2, C43.2, C44.2, C45.2, C46.2, C55.2, C56.2, C57.2, C58.2, C59.2, C60.2, C61.2, C62.2, C63.2, C64.2, C65.2, C66.2, C67.2, C68.2, C69.2, C70.2, D4.1 (K), D5.1 (K), D6.1 (K), D7.1 (K), D8.1 (K), D9.1 (K), D10.1 (K), D11.1 (K), D12.1 (K), D13.1 (K), D16.1 (K), D17.1 (K), D18.1 (K), D19.1 (K), R6.2, R9.1, R14.2, R21.2, R24.1, R29.2, R36.2, R39.1, R44.2, R51.2, R54.1, R59.2, R66.2, R69.1, R74.2, R96.2, R99.1, R104.2, R111.2, R114.1, R119.2, U2.4 (GND), U3.6 (V-), U3.14 (V-), U3.15 (PAD), U4.4 (V-), U5.4 (GND), U6.6 (V-), U6.14 (V-), U6.15 (PAD), U7.4 (V-), U8.4 (GND), U9.6 (V-), U9.14 (V-), U9.15 (PAD), U10.4 (V-), U11.4 (GND), U12.6 (V-), U12.14 (V-), U12.15 (PAD), U13.4 (V-), U14.4 (GND), U15.6 (V-), U15.14 (V-), U15.15 (PAD), U16.4 (V-), U20.4 (GND), U21.6 (V-), U21.14 (V-), U21.15 (PAD), U22.4 (V-), U23.4 (GND), U24.6 (V-), U24.14 (V-), U24.15 (PAD), U25.4 (V-); also elsewhere on the board
unnamed: D4.2 (A), R15.2
unnamed: D5.2 (A), R16.2
unnamed: D6.2 (A), R30.2
unnamed: D7.2 (A), R31.2
unnamed: D8.2 (A), R45.2
unnamed: D9.2 (A), R46.2
unnamed: D10.2 (A), R60.2
unnamed: D11.2 (A), R61.2
unnamed: D12.2 (A), R75.2
unnamed: D13.2 (A), R76.2
unnamed: D16.2 (A), R105.2
unnamed: D17.2 (A), R106.2
unnamed: D18.2 (A), R120.2
unnamed: D19.2 (A), R121.2
unnamed: R15.1, U4.1
unnamed: R16.1, U4.7
unnamed: R30.1, U7.1
unnamed: R31.1, U7.7
unnamed: R45.1, U10.1
unnamed: R46.1, U10.7
unnamed: R60.1, U13.1
unnamed: R61.1, U13.7
unnamed: R75.1, U16.1
unnamed: R76.1, U16.7
unnamed: R105.1, U22.1
unnamed: R106.1, U22.7
unnamed: R120.1, U25.1
unnamed: R121.1, U25.7
unnamed: R4.1, U2.1 (OUT1)
unnamed: R11.1, U2.7 (OUT2)
unnamed: C7.1, R2.2, U3.2 (IN1+)
unnamed: R8.2, R9.2, U3.1 (IN1-)
unnamed: C8.1, R3.2, U3.4 (IN2+)
unnamed: R5.2, R6.1, U3.5 (IN2-)
unnamed: R13.2, R14.1, U4.2 (-), U4.6 (-)
unnamed: R19.1, U5.1 (OUT1)
unnamed: R26.1, U5.7 (OUT2)
unnamed: C15.1, R17.2, U6.2 (IN1+)
unnamed: R23.2, R24.2, U6.1 (IN1-)
unnamed: C16.1, R18.2, U6.4 (IN2+)
unnamed: R20.2, R21.1, U6.5 (IN2-)
unnamed: R28.2, R29.1, U7.2 (-), U7.6 (-)
unnamed: R34.1, U8.1 (OUT1)
unnamed: R41.1, U8.7 (OUT2)
unnamed: C23.1, R32.2, U9.2 (IN1+)
unnamed: R38.2, R39.2, U9.1 (IN1-)
unnamed: C24.1, R33.2, U9.4 (IN2+)
unnamed: R35.2, R36.1, U9.5 (IN2-)
unnamed: R43.2, R44.1, U10.2 (-), U10.6 (-)
unnamed: R49.1, U11.1 (OUT1)
unnamed: R56.1, U11.7 (OUT2)
unnamed: C31.1, R47.2, U12.2 (IN1+)
unnamed: R53.2, R54.2, U12.1 (IN1-)
unnamed: C32.1, R48.2, U12.4 (IN2+)
unnamed: R50.2, R51.1, U12.5 (IN2-)
unnamed: R58.2, R59.1, U13.2 (-), U13.6 (-)
unnamed: R64.1, U14.1 (OUT1)
unnamed: R71.1, U14.7 (OUT2)
unnamed: C39.1, R62.2, U15.2 (IN1+)
unnamed: R68.2, R69.2, U15.1 (IN1-)
unnamed: C40.1, R63.2, U15.4 (IN2+)
unnamed: R65.2, R66.1, U15.5 (IN2-)
unnamed: R73.2, R74.1, U16.2 (-), U16.6 (-)
unnamed: R94.1, U20.1 (OUT1)
unnamed: R101.1, U20.7 (OUT2)
unnamed: C55.1, R92.2, U21.2 (IN1+)
unnamed: R98.2, R99.2, U21.1 (IN1-)
unnamed: C56.1, R93.2, U21.4 (IN2+)
unnamed: R95.2, R96.1, U21.5 (IN2-)
unnamed: R103.2, R104.1, U22.2 (-), U22.6 (-)
unnamed: R109.1, U23.1 (OUT1)
unnamed: R116.1, U23.7 (OUT2)
unnamed: C63.1, R107.2, U24.2 (IN1+)
unnamed: R113.2, R114.2, U24.1 (IN1-)
unnamed: C64.1, R108.2, U24.4 (IN2+)
unnamed: R110.2, R111.1, U24.5 (IN2-)
unnamed: R118.2, R119.1, U25.2 (-), U25.6 (-)

Notes on the sheet:
SUB FOR TLV1812!!
