kpezeshki/16CH_PSU/multichannelheaterdriver_frontend/multichannelheaterdriver_frontend.kicad_pcb

## KiCad design multichannelheaterdriver_frontend/multichannelheaterdriver_frontend.kicad_pcb (continued)

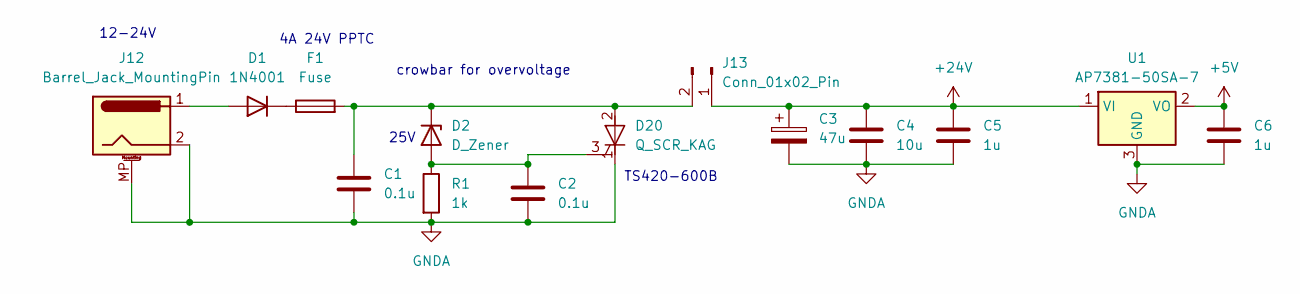
[picture p12: schematic powersupply.kicad_sch]

Parts:
C1, C2: 0.1u; C_0603_1608Metric
C3: 47u; CP_Radial_D6.3mm_P2.50mm
C4: 10u; C_0805_2012Metric
C5, C6: 1u; C_0603_1608Metric
D1: 1N4001; D_DO-41_SOD81_P10.16mm_Horizontal
D2: D_Zener; D_SOD-123
D20: Q_SCR_KAG; TO-252-3_TabPin2
F1: Fuse; Fuse_1206_3216Metric
J12: Barrel_Jack_MountingPin; BarrelJack_CUI_PJ-063AH_Horizontal
J13: Conn_01x02_Pin; PinHeader_1x02_P2.54mm_Horizontal
R1: 1k; R_0603_1608Metric
U1: AP7381-50SA-7; SOT-23

Connections:
+5V: C6.1, U1.2 (VO); also elsewhere on the board
+24V: C3.1, C4.1, C5.1, J13.1, U1.1 (VI); also elsewhere on the board
GNDA: C1.2, C2.2, C3.2, C4.2, C5.2, C6.2, D20.1 (K), J12.2, J12.MP (MountPin), R1.2, U1.3 (GND); also elsewhere on the board
unnamed: D1.2 (A), J12.1
unnamed: D1.1 (K), F1.1
unnamed: C2.1, D2.2 (A), D20.3 (G), R1.1
unnamed: C1.1, D2.1 (K), D20.2 (A), F1.2, J13.2

Notes on the sheet:
25V
12-24V
4A 24V PPTC
TS420-600B
crowbar for overvoltage

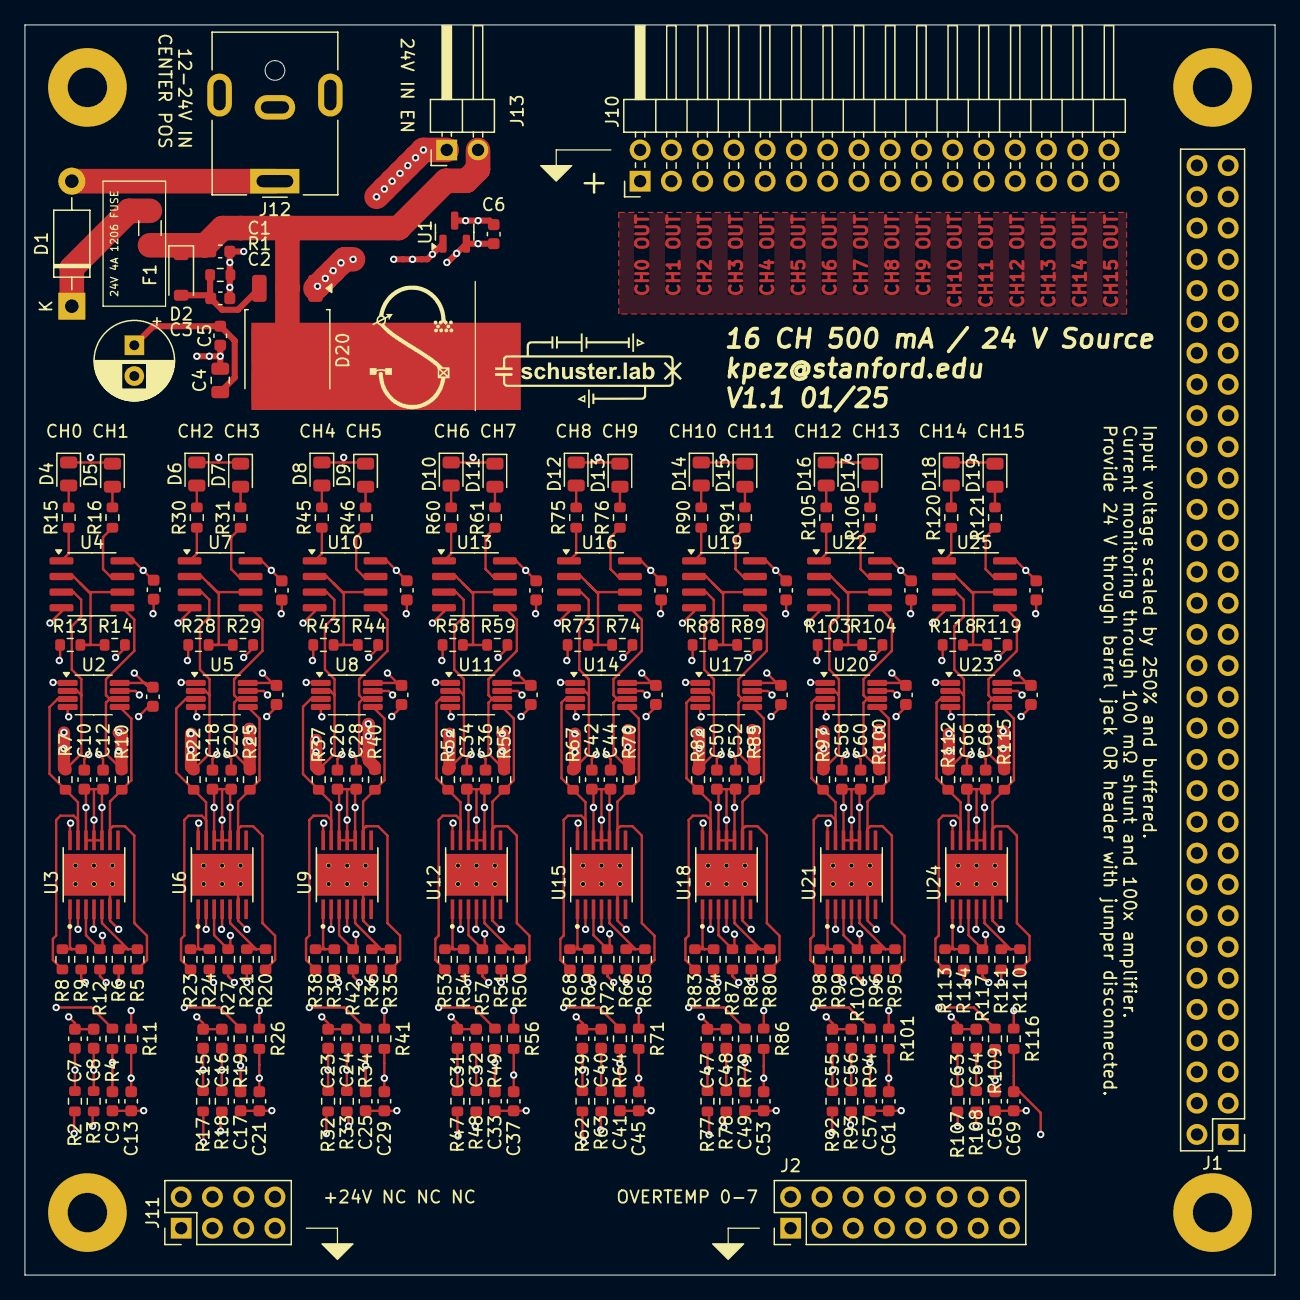
[picture p13: board multichannelheaterdriver_frontend.kicad_pcb from above]

Board: 6 copper layers, 101.6 x 101.6 mm, 246 parts (0 on the bottom side), 167 nets.
